oANWCHo/PTuk_TrainDriver/PCB_MotorDriver/3D/5930-0.2mΩ.STEP

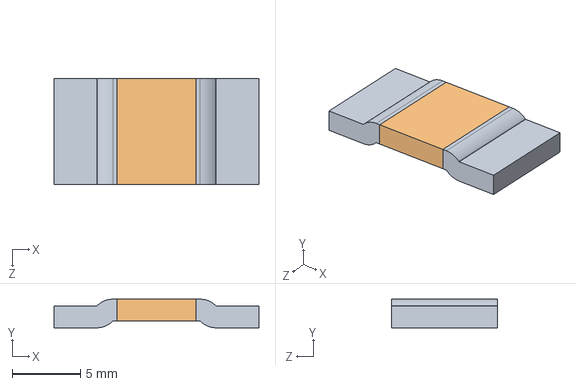
[picture p1: CAD file, 2026-06-28]
PCB_MotorDriver/3D/5930-0.2mΩ.STEP
15.0 x 2.10 x 7.75 mm
