oANWCHo/PTuk_TrainDriver/PCB_TrainController/3D/ESP32-S3-DEVKITC-1-N8R8.step

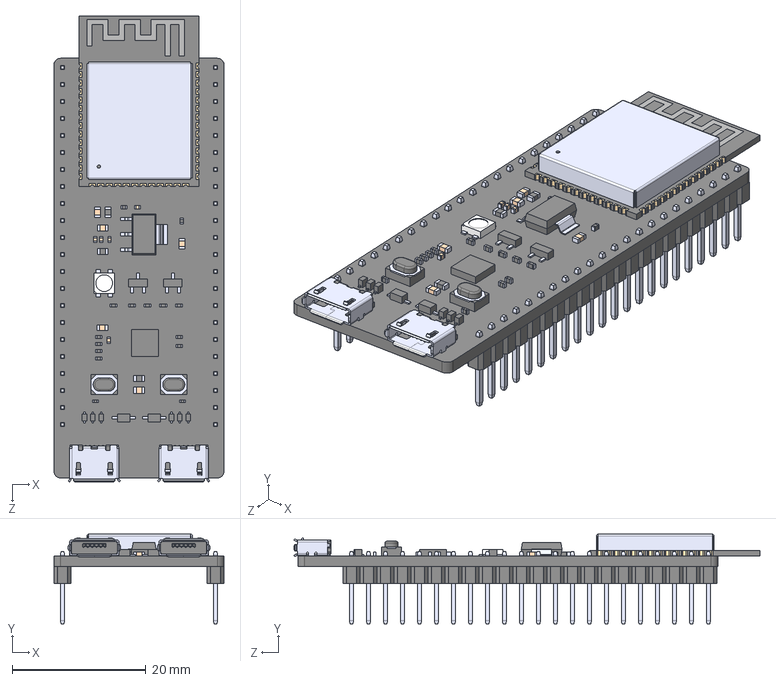
[picture p2: CAD file, 2026-07-12]
PCB_TrainController/3D/ESP32-S3-DEVKITC-1-N8R8.step
25.4 x 13.4 x 69.6 mm
