oANWCHo/PTuk_TrainDriver/PCB_MotorDriver/3D/User Library-TDSON-8-1.STEP

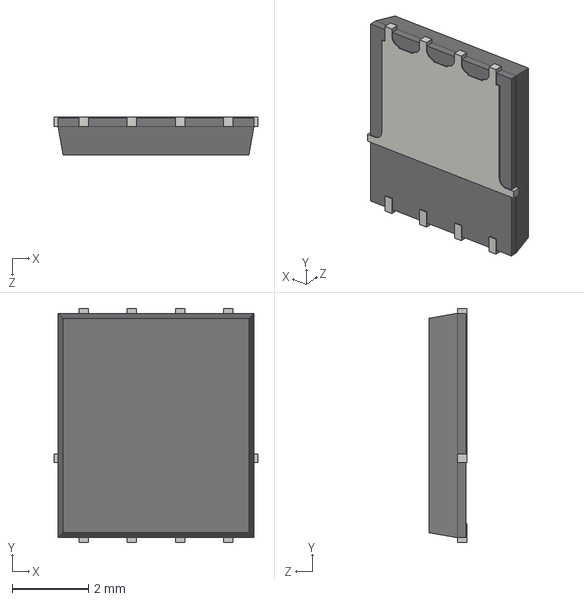
[picture p3: CAD file, 2026-06-28]
PCB_MotorDriver/3D/User Library-TDSON-8-1.STEP
5.35 x 6.15 x 1.00 mm
