oANWCHo/PTuk_TrainDriver/PCB_MotorDriver/3D/XT60PW-M--3DModel-STEP-740395.STEP

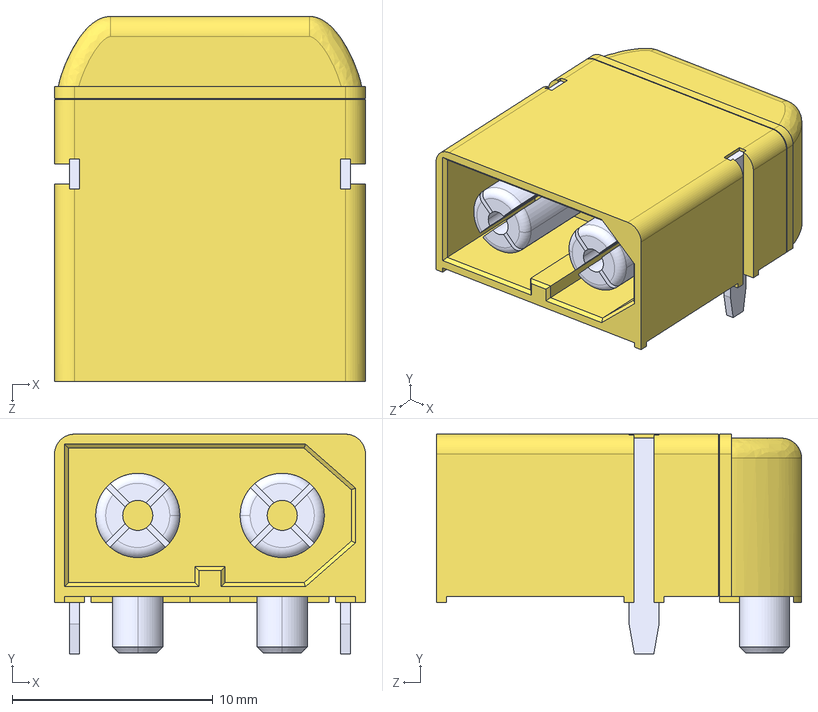
[picture p4: CAD file, 2026-06-28]
PCB_MotorDriver/3D/XT60PW-M--3DModel-STEP-740395.STEP
15.5 x 10.9 x 18.2 mm
