oANWCHo/PTuk_TrainDriver/PCB_MotorDriver/3D/XT90PW-M--3DModel-STEP-56544.STEP

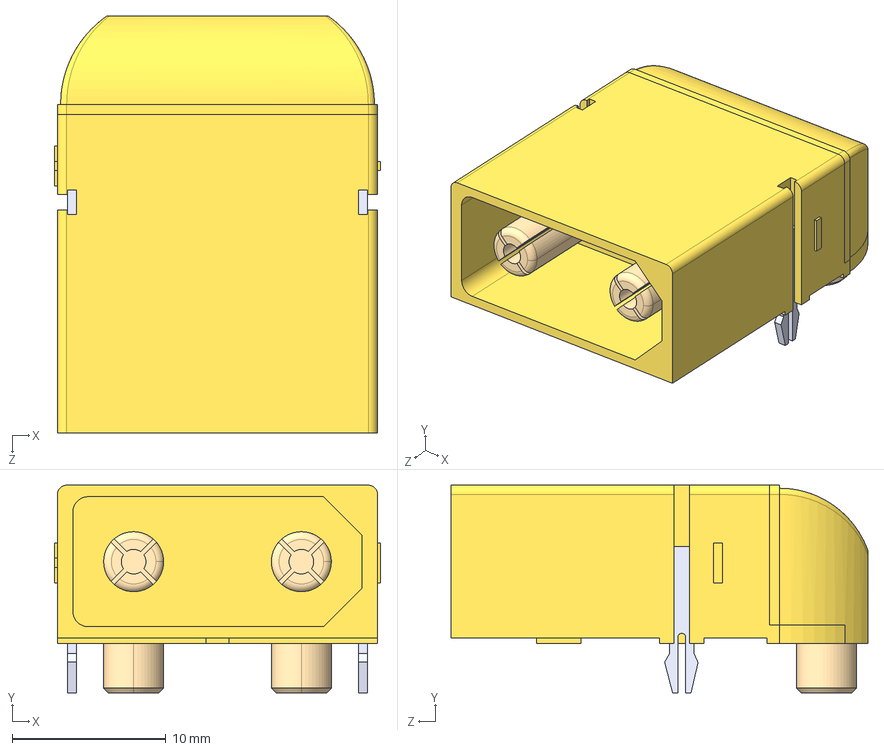
[picture p5: CAD file, 2026-06-28]
PCB_MotorDriver/3D/XT90PW-M--3DModel-STEP-56544.STEP
21.2 x 13.5 x 27.1 mm
