oANWCHo/PTuk_TrainDriver/PCB_MotorDriver/3D/XT30PW-M--3DModel-STEP-269445.STEP

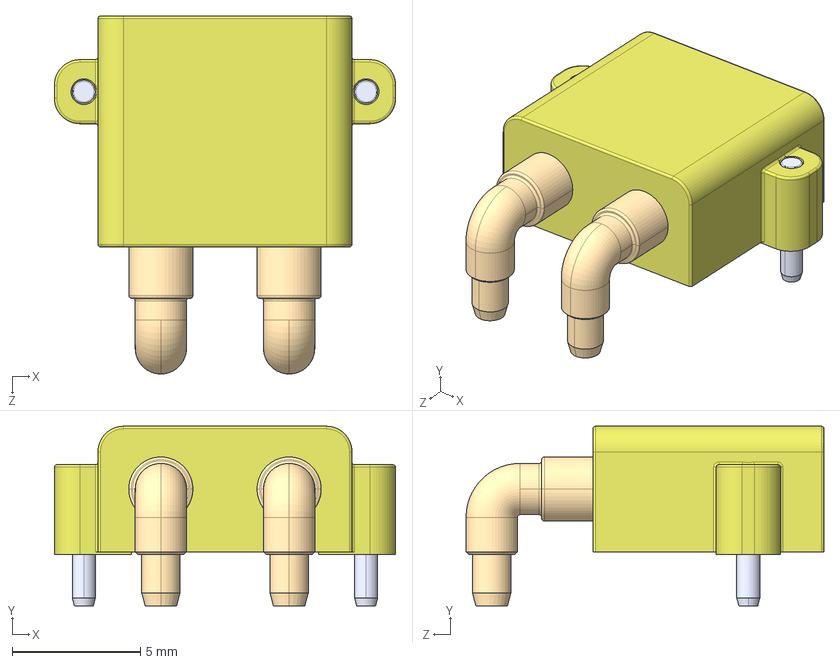
[picture p6: CAD file, 2026-06-28]
PCB_MotorDriver/3D/XT30PW-M--3DModel-STEP-269445.STEP
13.3 x 7.00 x 14.0 mm
