oANWCHo/PTuk_TrainDriver/PCB_TrainDriver/PCB_TrainDriver.kicad_pcb

## KiCad design PCB_TrainDriver/PCB_TrainDriver.kicad_pcb (2026-07-12)

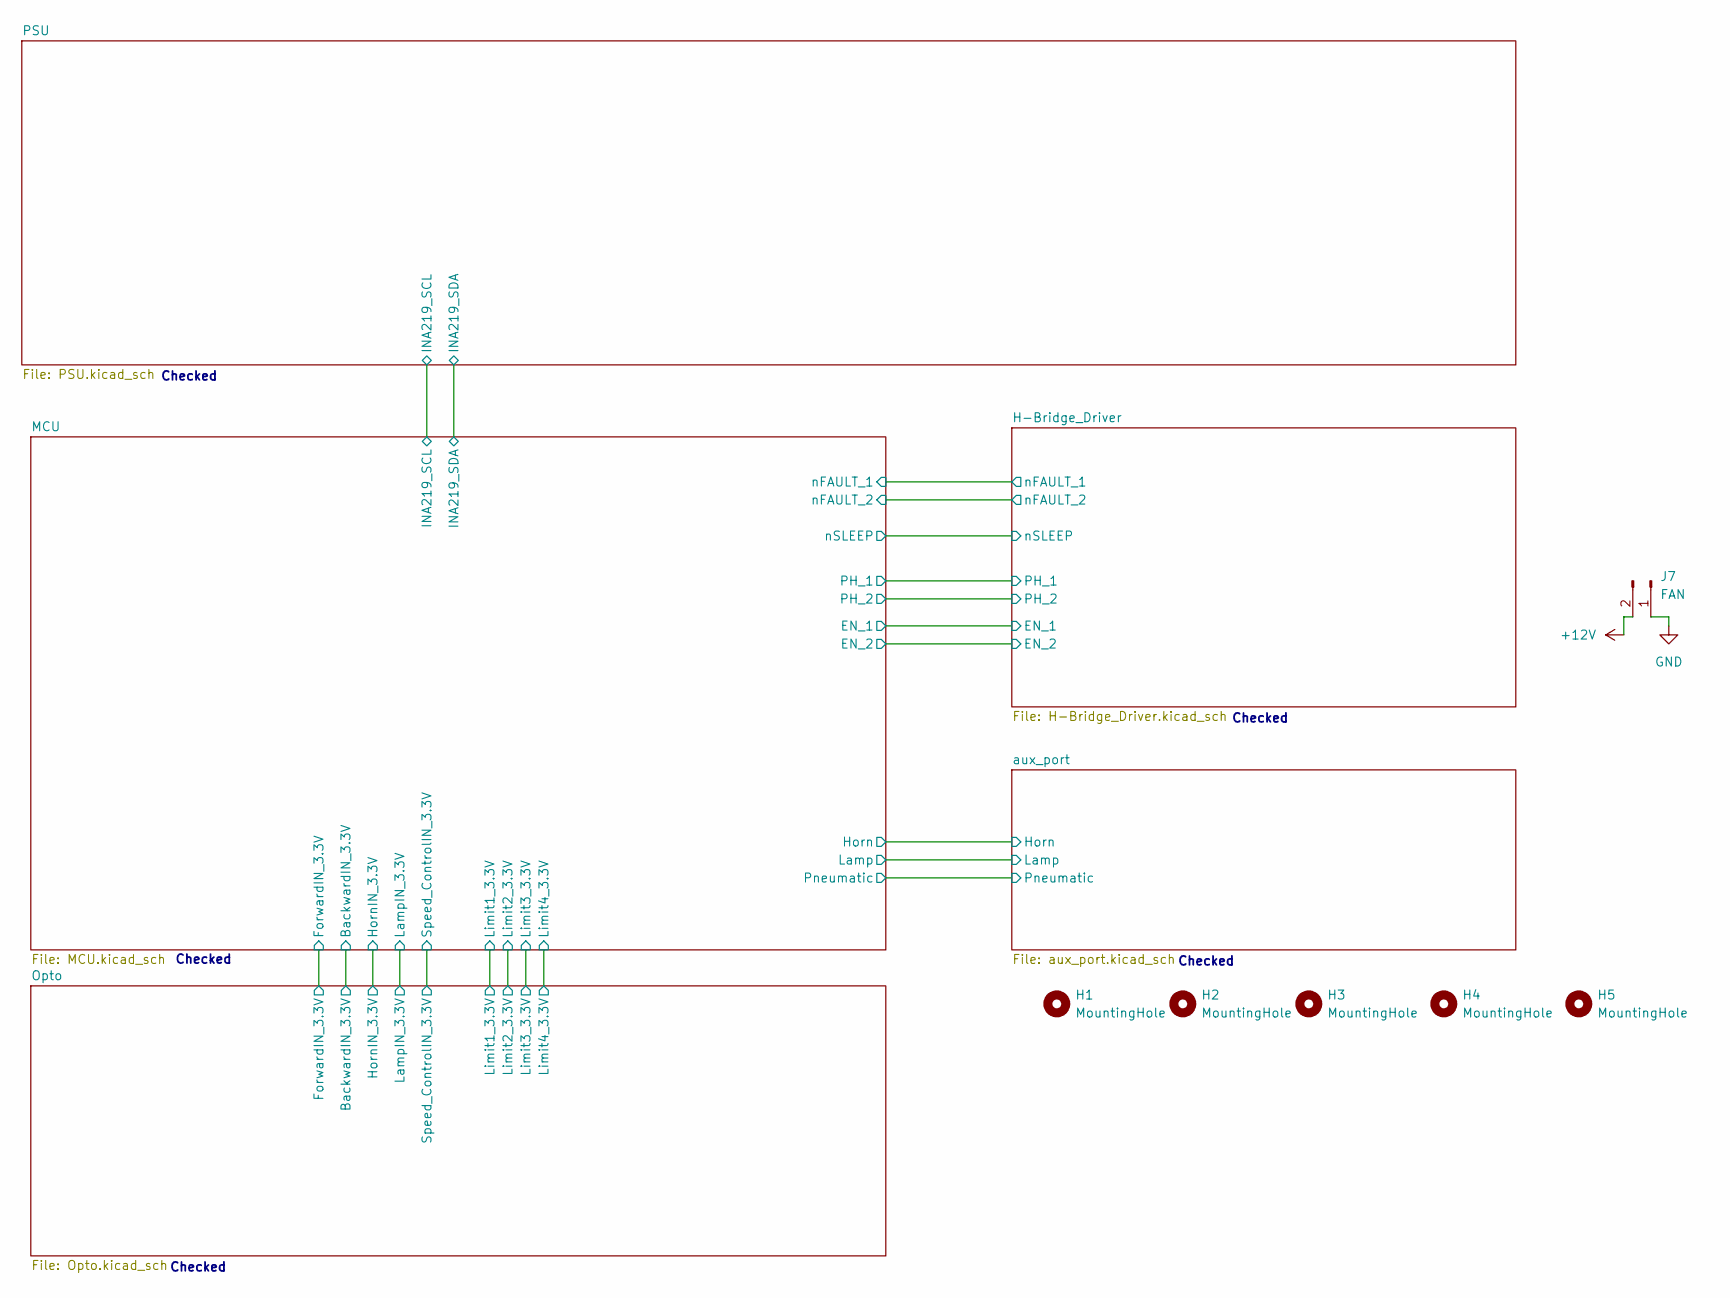
[picture p18: schematic PCB_TrainDriver.kicad_sch]

Parts:
H1, H2, H3, H4, H5: MountingHole; MountingHole_5.3mm_M5_DIN965_Pad
J7: FAN; JST_XA_B02B-XASK-1_1x02_P2.50mm_Vertical; JLCPCB Part # C265283

Connections:
+12V: J7.2; also elsewhere on the board
GND: J7.1; also elsewhere on the board

Notes on the sheet:
Checked

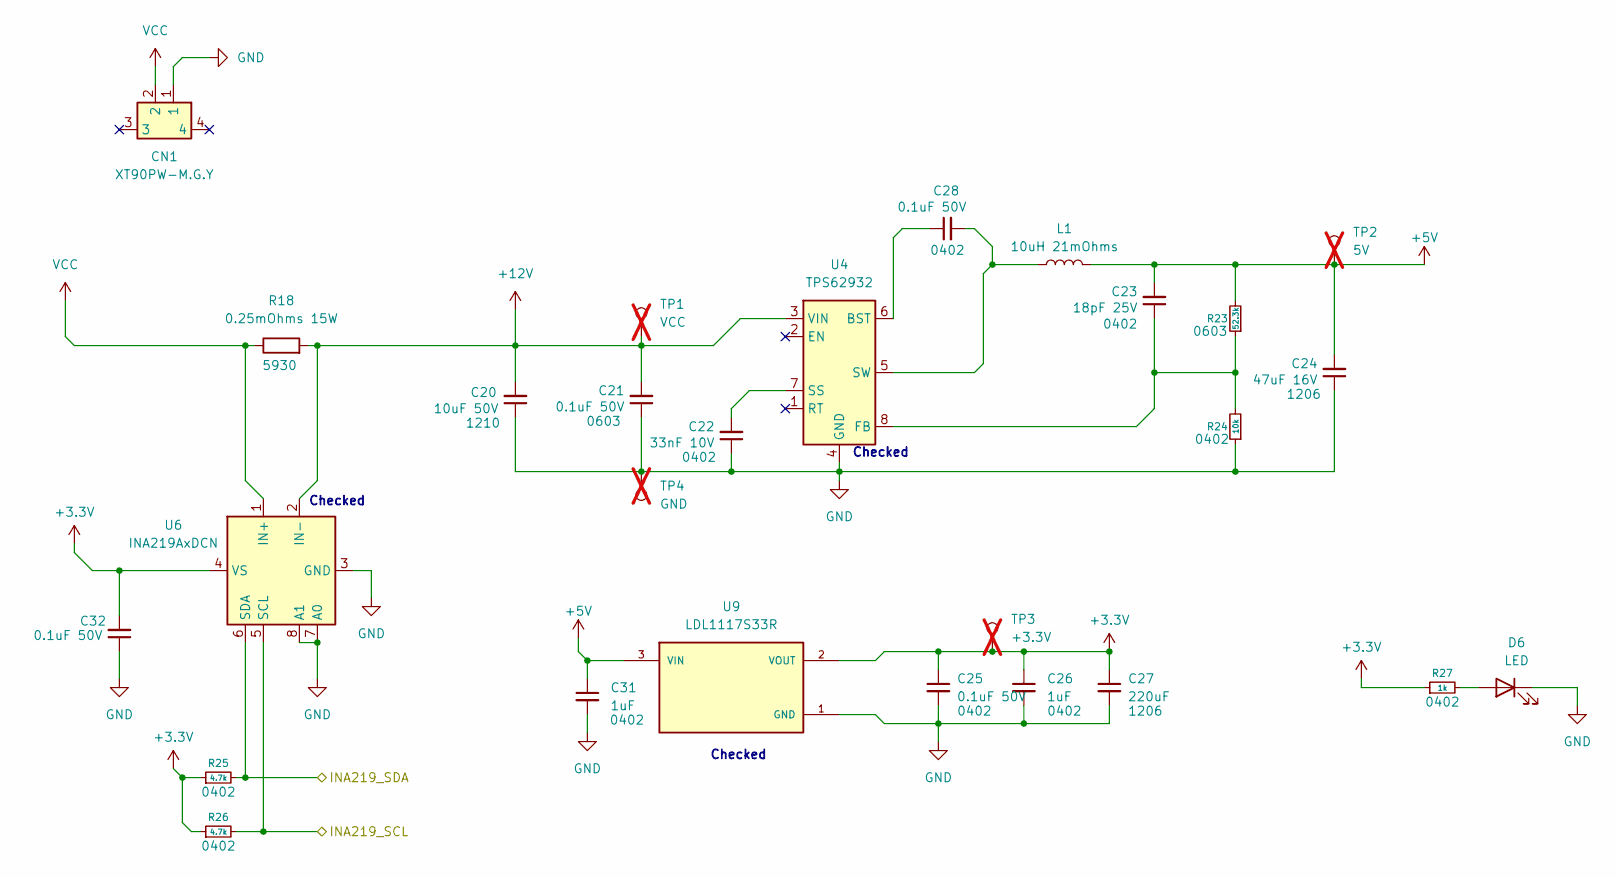
[picture p19: schematic PSU.kicad_sch]

Parts:
C20: 10uF 50V; C_1206_3216Metric; JLCPCB Part # C13585
C21: 0.1uF 50V; C_0603_1608Metric; JLCPCB Part # C14663
C22: 33nF 10V; C_0402_1005Metric; JLCPCB Part # C527022
C23: 18pF 25V; C_0402_1005Metric; JLCPCB Part # C526984
C24: 47uF 16V; C_1206_3216Metric; JLCPCB Part # C7472975
C25, C28, C32: 0.1uF 50V; C_0402_1005Metric; JLCPCB Part # C307331
C26, C31: 1uF; C_0402_1005Metric; JLCPCB Part # C52923
C27: 220uF; C_1206_3216Metric; JLCPCB Part # C412252
CN1: XT90PW-M.G.Y; CONN-TH_XT90PW-M.G.Y; Manufacturer Part XT90PW-M.G.Y; LCSC Part Name AMASS(艾迈斯)PCB焊板式卧式航模连接器 锂电池大电流插头 30A二芯P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
D6: LED; LED_0603_1608Metric; JLCPCB Part # C2286
L1: 10uH 21mOhms; L_12x12mm_H4.5mm; JLCPCB Part # C9904
R18: 0.25mOhms 15W; R5930; JLCPCB Part # C495779
R23: 52.3k; R_0603_1608Metric; JLCPCB Part # C23198
R24: 10k; R_0402_1005Metric; JLCPCB Part # C60490
R25, R26: 4.7k; R_0402_1005Metric; JLCPCB Part # C25900
R27: 1k; R_0402_1005Metric; JLCPCB Part # C11702
TP1: VCC; Pin_D0.7mm_L6.5mm_W1.8mm_FlatFork; not fitted
TP2: 5V; Pin_D0.7mm_L6.5mm_W1.8mm_FlatFork; not fitted
TP3: +3.3V; Pin_D0.7mm_L6.5mm_W1.8mm_FlatFork; not fitted
TP4: GND; Pin_D0.7mm_L6.5mm_W1.8mm_FlatFork; not fitted
U4: TPS62932; SOT-583-8; JLCPCB Part # C3032935
U6: INA219AxDCN; SOT-23-8; JLCPCB Part # C87469
U9: LDL1117S33R; SOT-223-3_TabPin2; PARTREV 7; JLCPCB Part # C18906017

Connections:
+3.3V: C25.1, C26.1, C27.1, C32.2, R25.1, R26.1, R27.1, TP3.1 (1_1), U6.4 (VS), U9.2 (VOUT), U9.4 (VOUT__1); also elsewhere on the board
+5V: C23.2, C24.2, C31.1, L1.2, R23.2, TP2.1 (1_1), U9.3 (VIN)
+12V: C20.2, C21.2, R18.2, TP1.1 (1_1), U4.3 (VIN), U6.2 (IN-); also elsewhere on the board
/MCU/INA219_SCL: R26.2, U6.5 (SCL); also elsewhere on the board
/MCU/INA219_SDA: R25.2, U6.6 (SDA); also elsewhere on the board
GND: C20.1, C21.1, C22.1, C24.1, C25.2, C26.2, C27.2, C31.2, C32.1, CN1.1, D6.1 (K), R24.1, TP4.1 (1_1), U4.4 (GND), U6.3 (GND), U6.7 (A0), U6.8 (A1), U9.1 (GND); also elsewhere on the board
unnamed: D6.2 (A), R27.2
unnamed: C28.1, U4.6 (BST)
unnamed: C23.1, R23.1, R24.2, U4.8 (FB)
unnamed: C22.2, U4.7 (SS)
unnamed: C28.2, L1.1, U4.5 (SW)
VCC: CN1.2, R18.1, U6.1 (IN+)

Notes on the sheet:
Checked

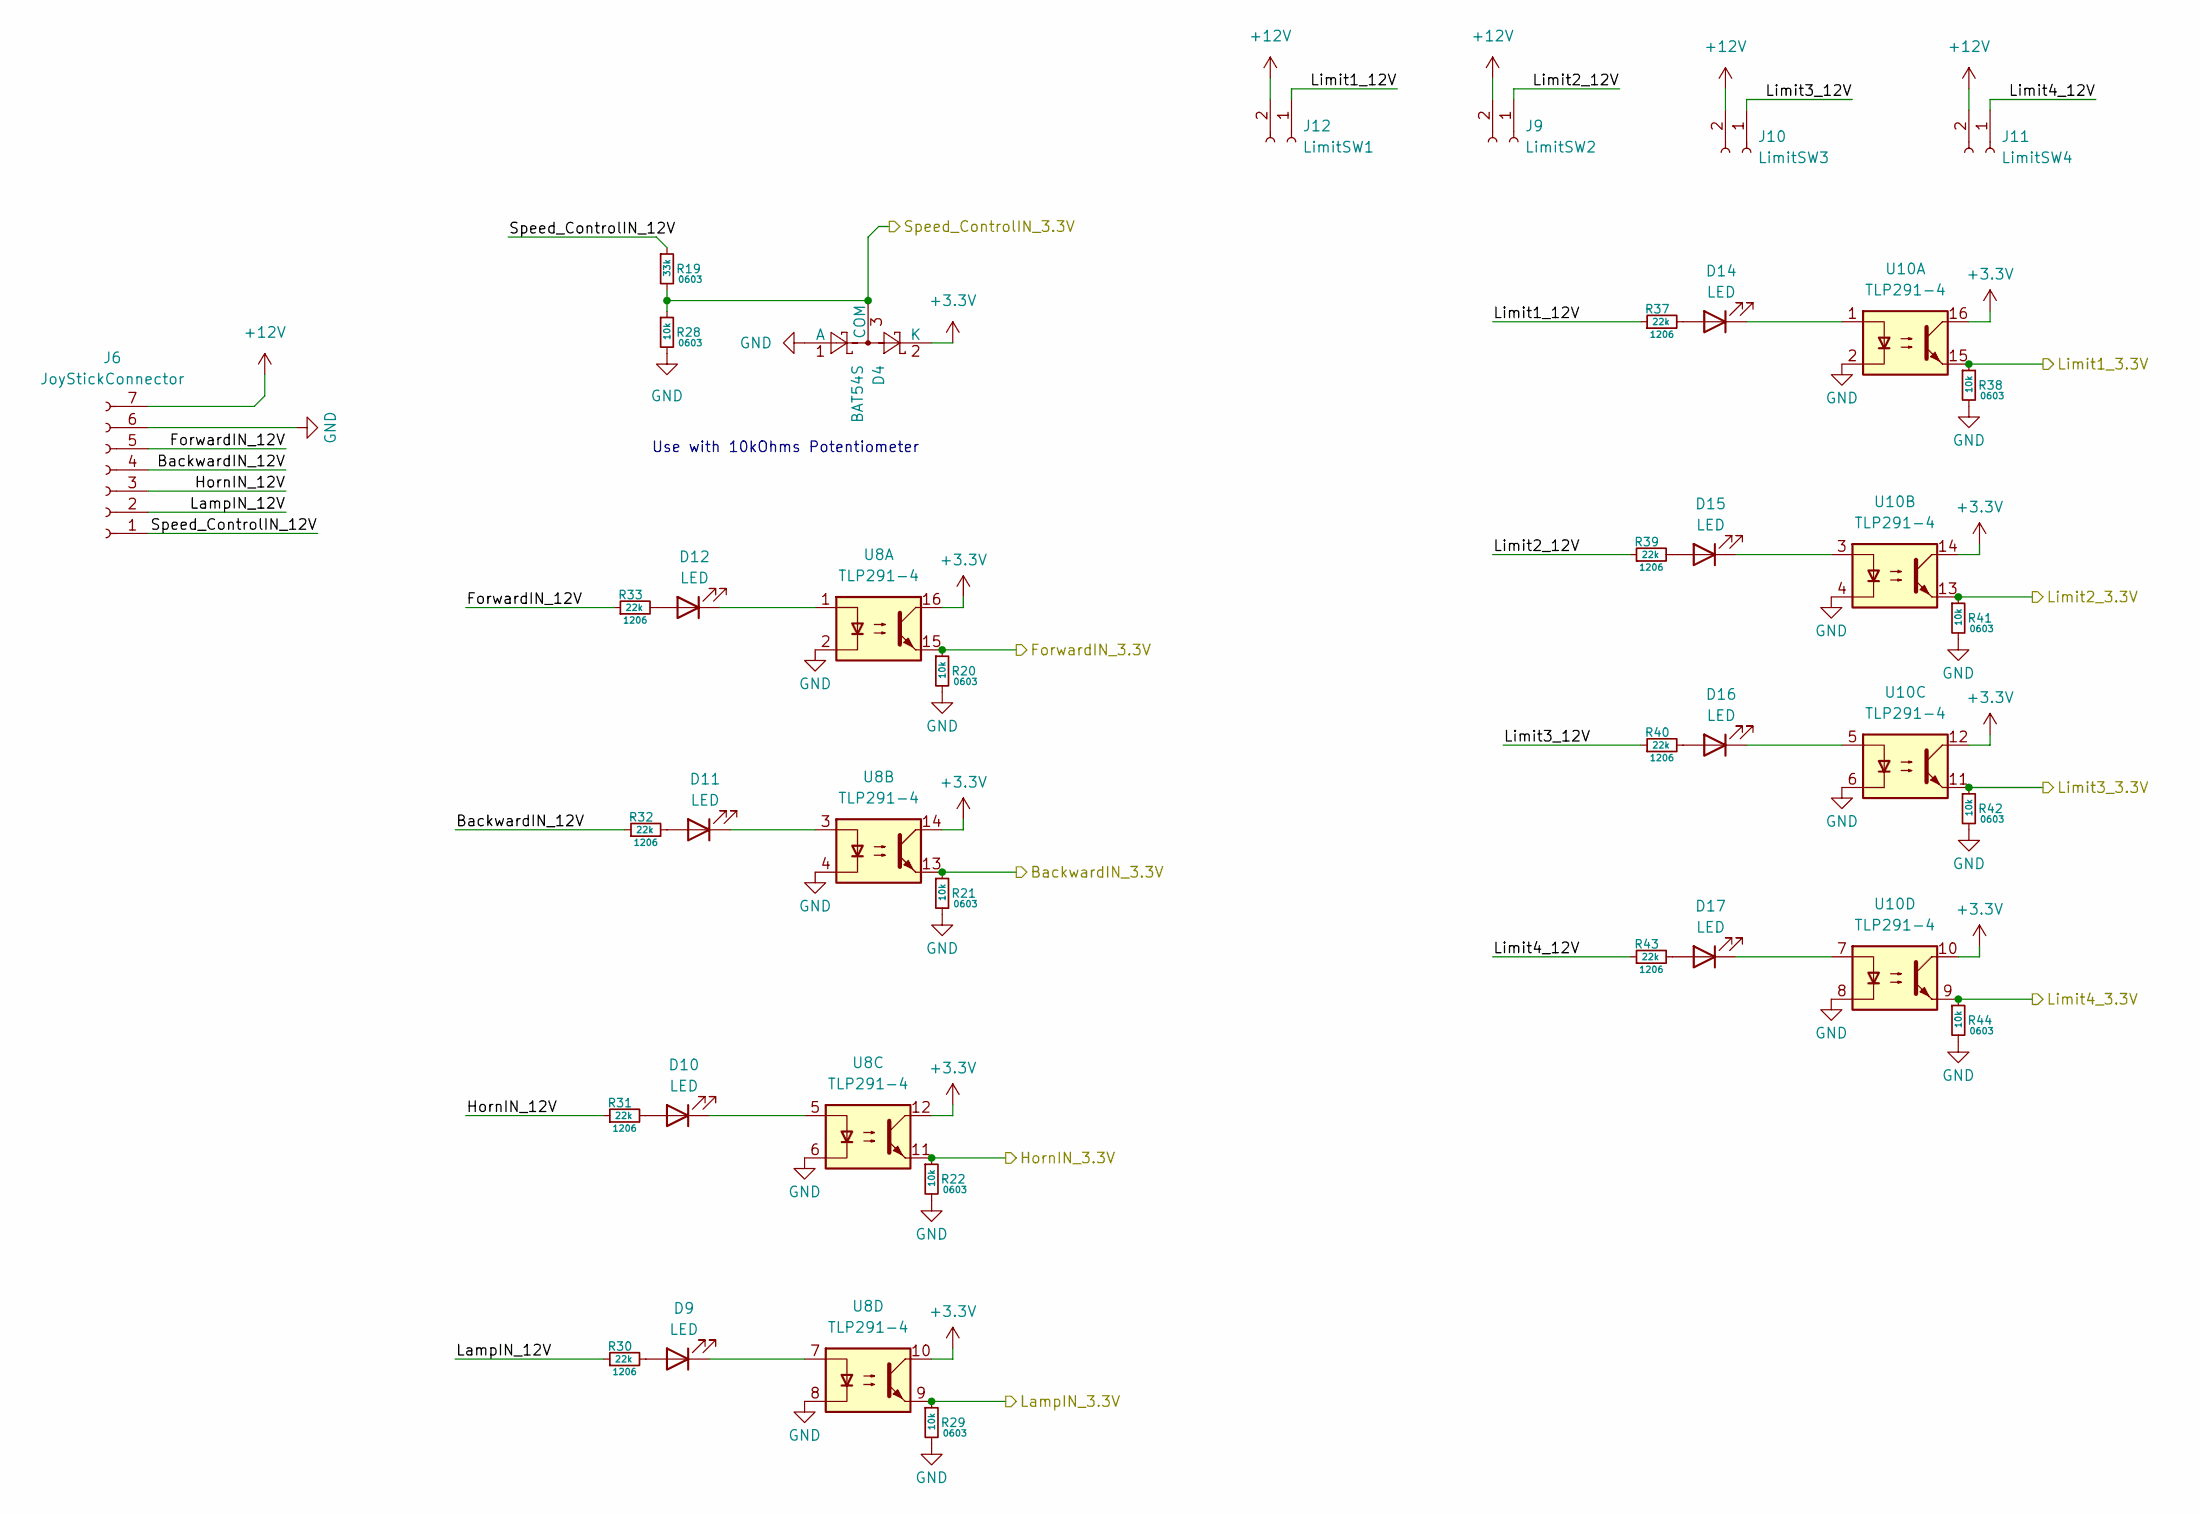
[picture p20: schematic Opto.kicad_sch]

Parts:
D4: BAT54S; SOT-23; JLCPCB Part # C19726
D9, D10, D11, D12, D14, D15, D16, D17: LED; LED_0603_1608Metric; JLCPCB Part # C2287
J6: JoyStickConnector; JST_XH_B7B-XH-A_1x07_P2.50mm_Vertical; JLCPCB Part # C144398
J9: LimitSW2; JST_XH_B2B-XH-A_1x02_P2.50mm_Vertical; JLCPCB Part # C265283
J10: LimitSW3; JST_XH_B2B-XH-A_1x02_P2.50mm_Vertical; JLCPCB Part # C265283
J11: LimitSW4; JST_XH_B2B-XH-A_1x02_P2.50mm_Vertical; JLCPCB Part # C265283
J12: LimitSW1; JST_XH_B2B-XH-A_1x02_P2.50mm_Vertical; JLCPCB Part # C265283
R19: 33k; R_0603_1608Metric; JLCPCB Part # C4216
R20, R21, R22, R28, R29, R38, R41, R42, R44: 10k; R_0603_1608Metric; JLCPCB Part # C25804
R30, R31, R32, R33, R37, R39, R40, R43: 22k; R_1206_3216Metric; JLCPCB Part # C25654
U8, U10: TLP291-4; SOIC-16_4.55x10.3mm_P1.27mm; JLCPCB Part # C60900

Connections:
+3.3V: D4.2 (K), U8.10, U8.12, U8.14, U8.16, U10.10, U10.12, U10.14, U10.16; also elsewhere on the board
+12V: J6.7, J9.2, J10.2, J11.2, J12.2; also elsewhere on the board
/MCU/BackwardIN_3.3V: R21.1, U8.13; also elsewhere on the board
/MCU/ForwardIN_3.3V: R20.1, U8.15; also elsewhere on the board
/MCU/HornIN_3.3V: R22.1, U8.11; also elsewhere on the board
/MCU/LampIN_3.3V: R29.1, U8.9; also elsewhere on the board
/MCU/Limit1_3.3V: R38.1, U10.15; also elsewhere on the board
/MCU/Limit2_3.3V: R41.1, U10.13; also elsewhere on the board
/MCU/Limit3_3.3V: R42.1, U10.11; also elsewhere on the board
/MCU/Limit4_3.3V: R44.1, U10.9; also elsewhere on the board
/MCU/Speed_ControlIN_3.3V: D4.3 (COM), R19.2, R28.1; also elsewhere on the board
/Opto/BackwardIN_12V: J6.4, R32.1
/Opto/ForwardIN_12V: J6.5, R33.1
/Opto/HornIN_12V: J6.3, R31.1
/Opto/LampIN_12V: J6.2, R30.1
/Opto/Limit1_12V: J12.1, R37.1
/Opto/Limit2_12V: J9.1, R39.1
/Opto/Limit3_12V: J10.1, R40.1
/Opto/Limit4_12V: J11.1, R43.1
/Opto/Speed_ControlIN_12V: J6.1, R19.1
GND: D4.1 (A), J6.6, R20.2, R21.2, R22.2, R28.2, R29.2, R38.2, R41.2, R42.2, R44.2, U8.2, U8.4, U8.6, U8.8, U10.2, U10.4, U10.6, U10.8; also elsewhere on the board
unnamed: D9.2 (A), R30.2
unnamed: D9.1 (K), U8.7
unnamed: D10.2 (A), R31.2
unnamed: D10.1 (K), U8.5
unnamed: D11.2 (A), R32.2
unnamed: D11.1 (K), U8.3
unnamed: D12.2 (A), R33.2
unnamed: D12.1 (K), U8.1
unnamed: D14.2 (A), R37.2
unnamed: D14.1 (K), U10.1
unnamed: D15.2 (A), R39.2
unnamed: D15.1 (K), U10.3
unnamed: D16.2 (A), R40.2
unnamed: D16.1 (K), U10.5
unnamed: D17.2 (A), R43.2
unnamed: D17.1 (K), U10.7

Notes on the sheet:
Use with 10kOhms Potentiometer

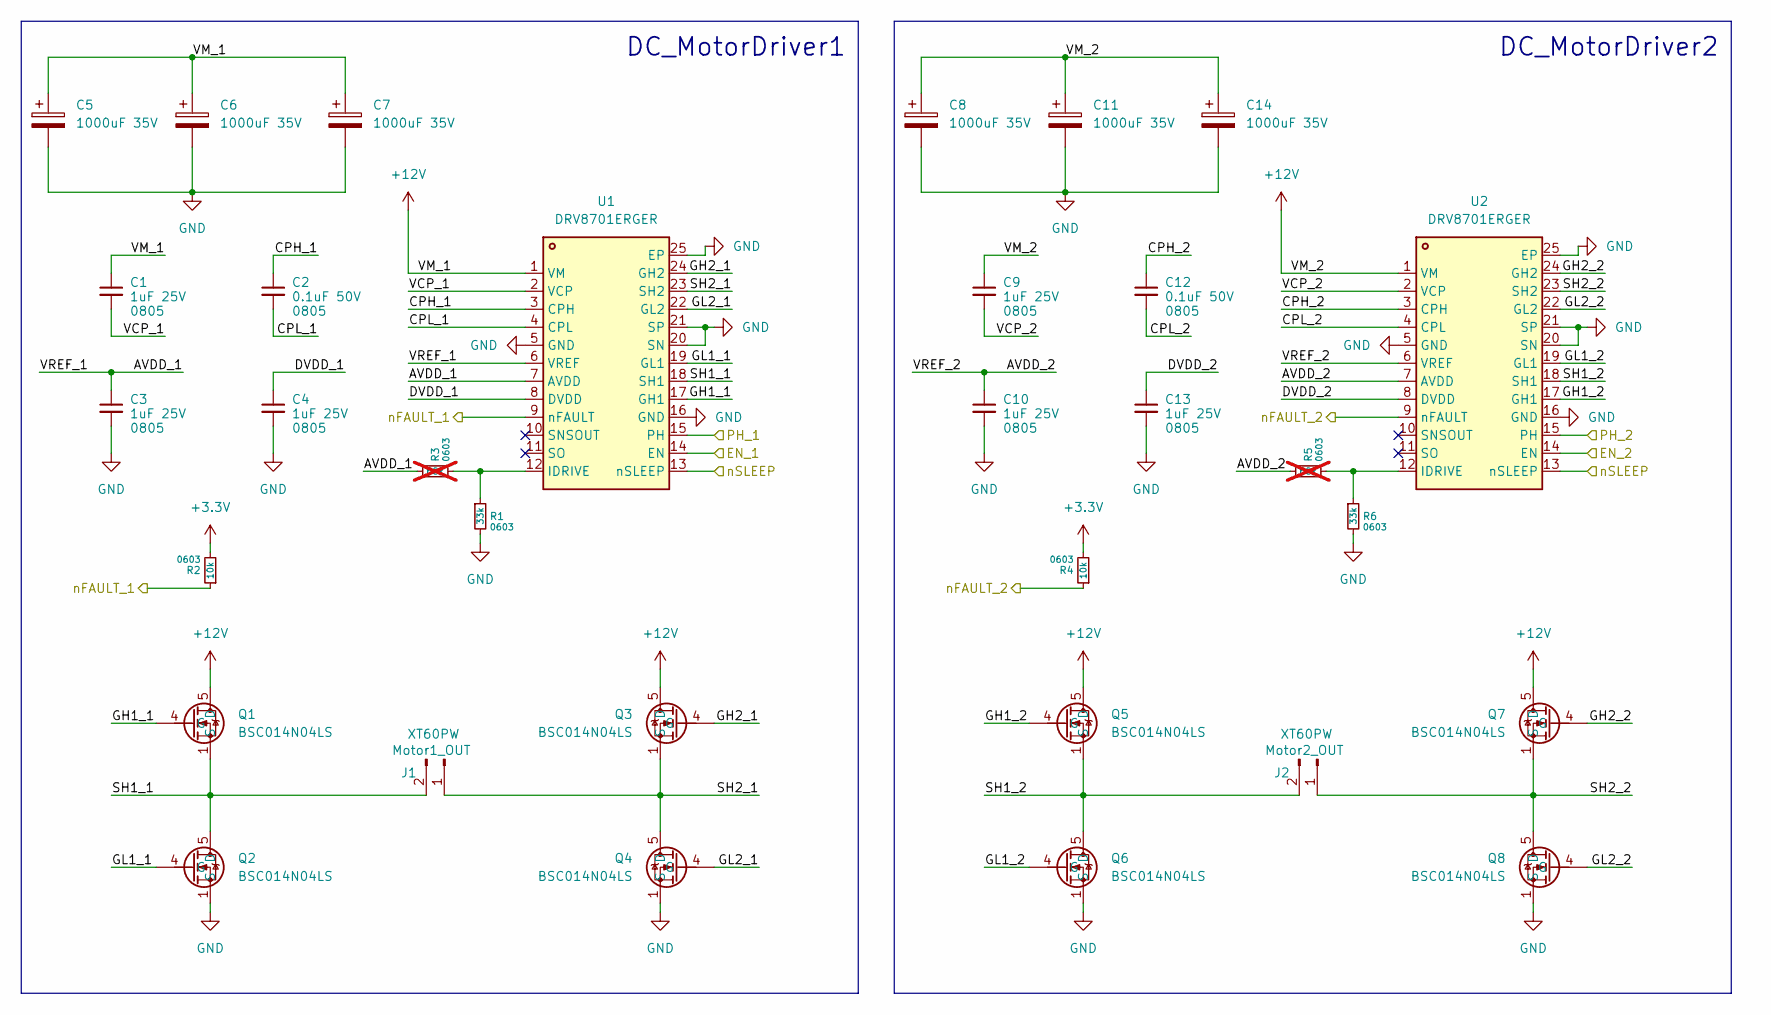
[picture p21: schematic H-Bridge_Driver.kicad_sch]

Parts:
C1, C3, C4, C9, C10, C13: 1uF 25V; C_0805_2012Metric; JLCPCB Part # C5137482
C2, C12: 0.1uF 50V; C_0805_2012Metric; JLCPCB Part # C49678
C5, C6, C7, C8, C11, C14: 1000uF 35V; CP_Elec_10x10; JLCPCB Part # C46550395
J1: Motor1_OUT; AMASS_XT60PW-M_1x02_P7.20mm_Horizontal; JLCPCB Part # C98732
J2: Motor2_OUT; AMASS_XT60PW-M_1x02_P7.20mm_Horizontal; JLCPCB Part # C98732
Q1, Q2, Q3, Q4, Q5, Q6, Q7, Q8: BSC014N04LS; Infineon_PG-TDSON-8_6.15x5.15mm; JLCPCB Part # C2760081
R1, R6: 33k; R_0603_1608Metric; JLCPCB Part # C4216
R2, R4: 10k; R_0603_1608Metric; JLCPCB Part # C25804
R3, R5: 68k; R_0603_1608Metric; JLCPCB Part # C23231; not fitted
U1, U2: DRV8701ERGER; VQFN-24-1EP_4x4mm_P0.5mm_EP2.45x2.45mm; Manufacturer Part DRV8701ERGER; JLCPCB Part # C90964

Connections:
+3.3V: R2.2, R4.2; also elsewhere on the board
+12V: C1.1, C5.1, C6.1, C7.1, C8.1, C9.1, C11.1, C14.1, Q1.5 (D), Q3.5 (D), Q5.5 (D), Q7.5 (D), U1.1 (VM), U2.1 (VM); also elsewhere on the board
/H-Bridge_Driver/AVDD_1: C3.1, R3.1, U1.6 (VREF), U1.7 (AVDD)
/H-Bridge_Driver/AVDD_2: C10.1, R5.1, U2.6 (VREF), U2.7 (AVDD)
/H-Bridge_Driver/CPH_1: C2.1, U1.3 (CPH)
/H-Bridge_Driver/CPH_2: C12.1, U2.3 (CPH)
/H-Bridge_Driver/CPL_1: C2.2, U1.4 (CPL)
/H-Bridge_Driver/CPL_2: C12.2, U2.4 (CPL)
/H-Bridge_Driver/DVDD_1: C4.1, U1.8 (DVDD)
/H-Bridge_Driver/DVDD_2: C13.1, U2.8 (DVDD)
/H-Bridge_Driver/EN_1: U1.14 (EN); also elsewhere on the board
/H-Bridge_Driver/EN_2: U2.14 (EN); also elsewhere on the board
/H-Bridge_Driver/GH1_1: Q1.4 (G), U1.17 (GH1)
/H-Bridge_Driver/GH1_2: Q5.4 (G), U2.17 (GH1)
/H-Bridge_Driver/GH2_1: Q3.4 (G), U1.24 (GH2)
/H-Bridge_Driver/GH2_2: Q7.4 (G), U2.24 (GH2)
/H-Bridge_Driver/GL1_1: Q2.4 (G), U1.19 (GL1)
/H-Bridge_Driver/GL1_2: Q6.4 (G), U2.19 (GL1)
/H-Bridge_Driver/GL2_1: Q4.4 (G), U1.22 (GL2)
/H-Bridge_Driver/GL2_2: Q8.4 (G), U2.22 (GL2)
/H-Bridge_Driver/PH_1: U1.15 (PH); also elsewhere on the board
/H-Bridge_Driver/PH_2: U2.15 (PH); also elsewhere on the board
/H-Bridge_Driver/SH1_1: J1.2, Q1.1 (S), Q1.2 (S), Q1.3 (S), Q2.5 (D), U1.18 (SH1)
/H-Bridge_Driver/SH1_2: J2.2, Q5.1 (S), Q5.2 (S), Q5.3 (S), Q6.5 (D), U2.18 (SH1)
/H-Bridge_Driver/SH2_1: J1.1, Q3.1 (S), Q3.2 (S), Q3.3 (S), Q4.5 (D), U1.23 (SH2)
/H-Bridge_Driver/SH2_2: J2.1, Q7.1 (S), Q7.2 (S), Q7.3 (S), Q8.5 (D), U2.23 (SH2)
/H-Bridge_Driver/VCP_1: C1.2, U1.2 (VCP)
/H-Bridge_Driver/VCP_2: C9.2, U2.2 (VCP)
/H-Bridge_Driver/nFAULT_1: R2.1, U1.9 (nFAULT); also elsewhere on the board
/H-Bridge_Driver/nFAULT_2: R4.1, U2.9 (nFAULT); also elsewhere on the board
/H-Bridge_Driver/nSLEEP: U1.13 (nSLEEP), U2.13 (nSLEEP); also elsewhere on the board
GND: C3.2, C4.2, C5.2, C6.2, C7.2, C8.2, C10.2, C11.2, C13.2, C14.2, Q2.1 (S), Q2.2 (S), Q2.3 (S), Q4.1 (S), Q4.2 (S), Q4.3 (S), Q6.1 (S), Q6.2 (S), Q6.3 (S), Q8.1 (S), Q8.2 (S), Q8.3 (S), R1.2, R6.2, U1.5 (GND), U1.16 (GND), U1.20 (SN), U1.21 (SP), U1.25 (EP), U2.5 (GND), U2.16 (GND), U2.20 (SN), U2.21 (SP), U2.25 (EP); also elsewhere on the board
unnamed: R1.1, R3.2, U1.12 (IDRIVE)
unnamed: R5.2, R6.1, U2.12 (IDRIVE)

Notes on the sheet:
DC_MotorDriver1
DC_MotorDriver2

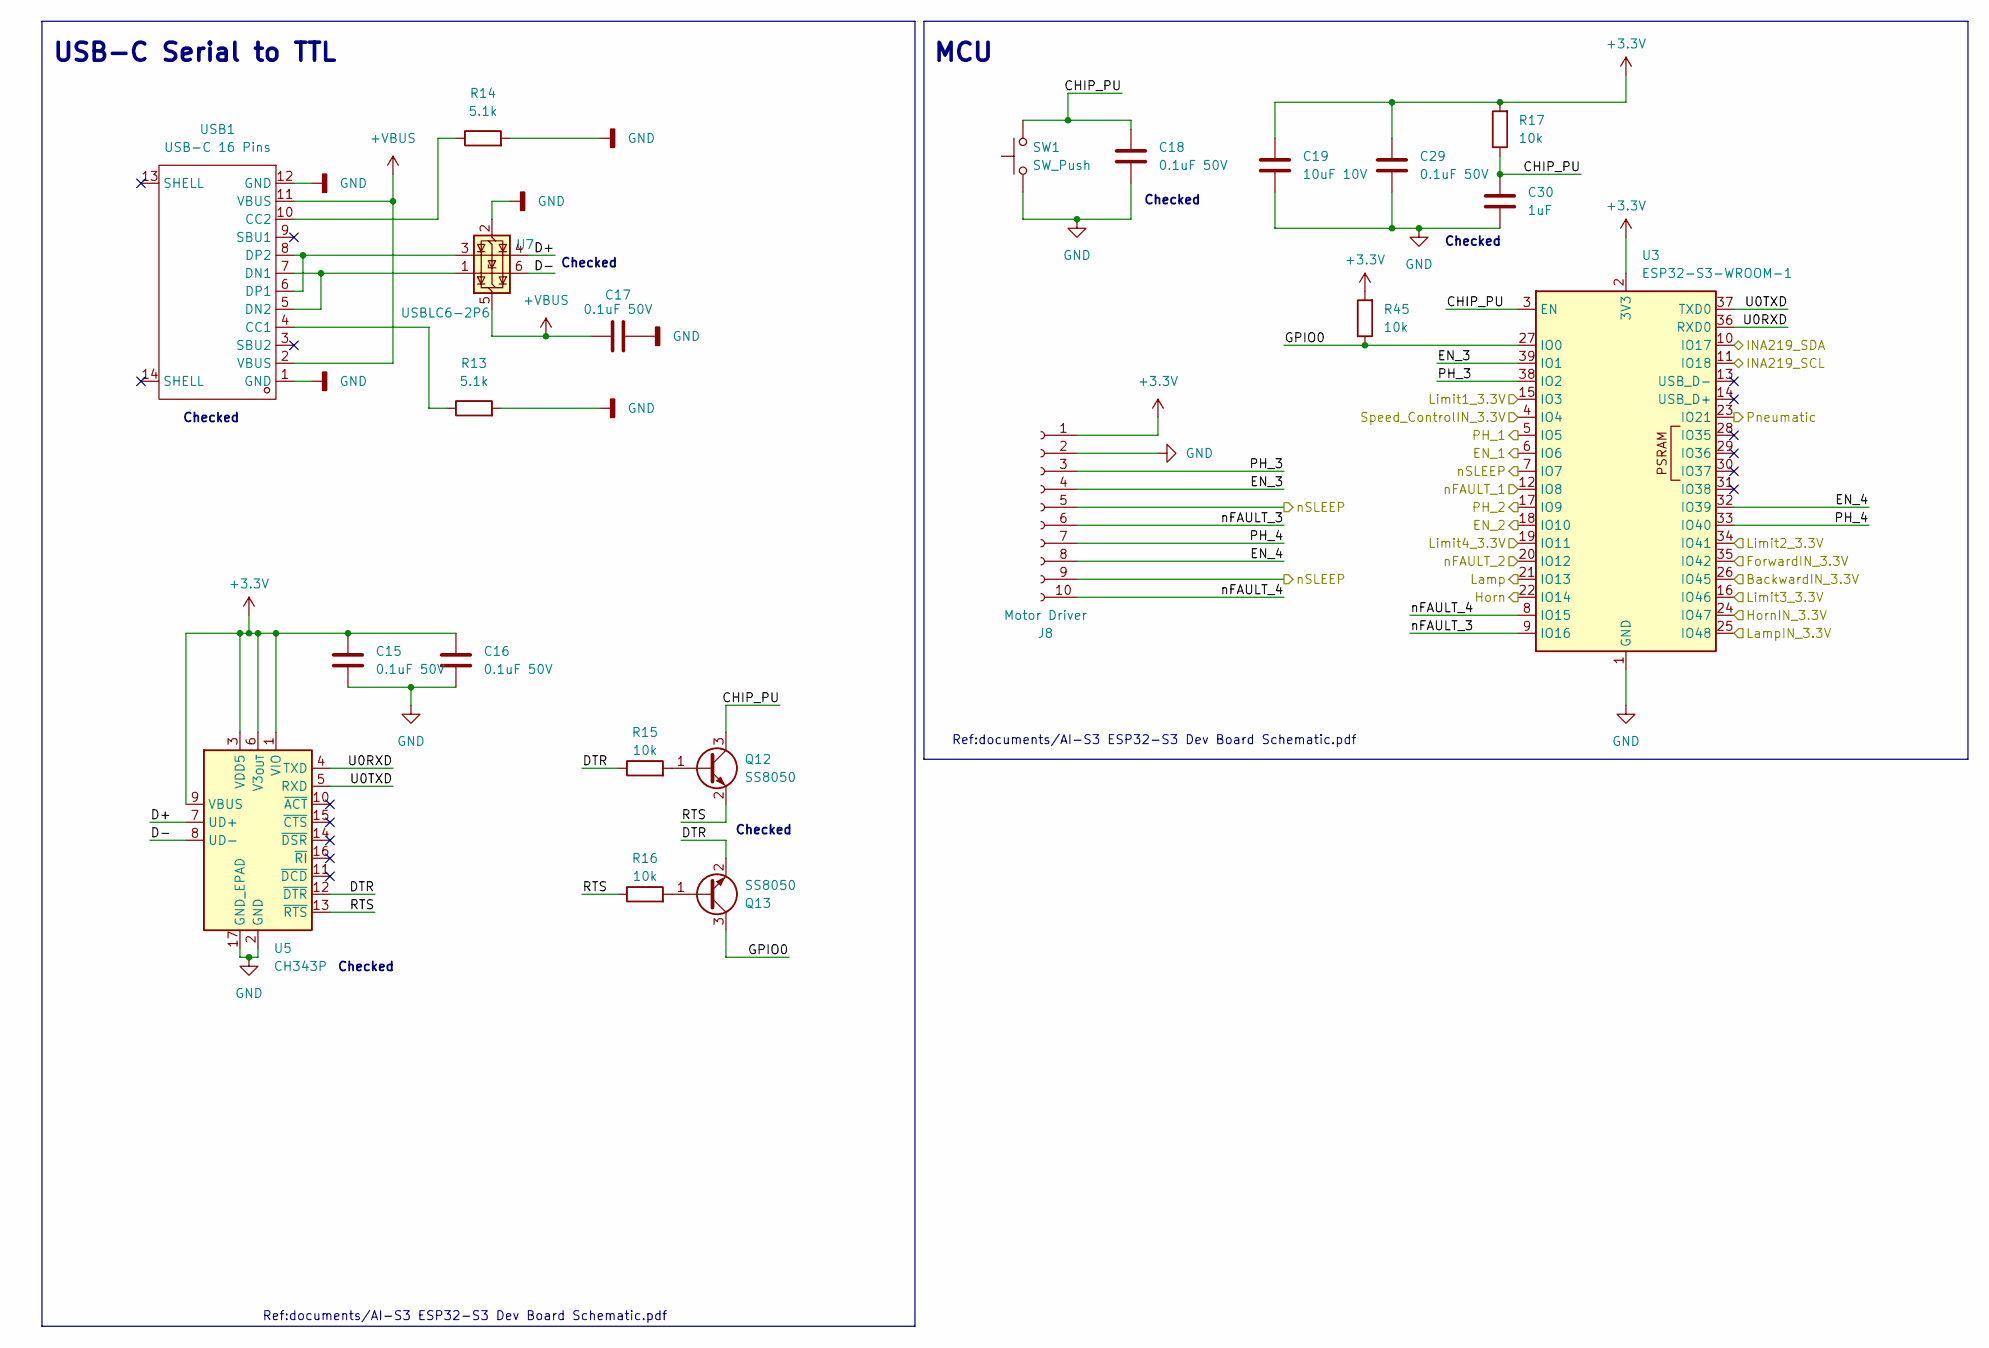
[picture p22: schematic MCU.kicad_sch]

Parts:
C15, C16, C17, C18, C29: 0.1uF 50V; C_0402_1005Metric; JLCPCB Part # C307331
C19: 10uF 10V; C_0402_1005Metric; JLCPCB Part # C2846677
C30: 1uF; C_0402_1005Metric; JLCPCB Part # C52923
J8: Motor Driver; JST_XH_B10B-XH-A_1x10_P2.50mm_Vertical; JLCPCB Part # C144400
Q12, Q13: SS8050; SOT-23; JLCPCB Part # C2150
R13, R14: 5.1k; R_0603_1608Metric; JLCPCB Part # C23186
R15, R16, R17, R45: 10k; R_0402_1005Metric; JLCPCB Part # C60490
SW1: SW_Push; SW_Tactile_SPST_NO_Straight_CK_PTS636Sx25SMTRLFS; JLCPCB Part # C118141
U3: ESP32-S3-WROOM-1; JLCPCB Part # C2913198
U5: CH343P; WCH_QFN-16-1EP_3x3mm_P0.5mm_EP1.8x1.8mm; JLCPCB Part # C2846043
U7: USBLC6-2P6; SOT-666; JLCPCB Part # C15999
USB1: USB-C 16 Pins; USB-C-SMD_TYPE-C-16PIN; Manufacturer Part TYPE-C 16PIN 2MD(073); JLCPCB Part # C393939

Connections:
+3.3V: C15.1, C16.1, C19.1, C29.1, J8.1, R17.2, R45.2, U3.2 (3V3), U5.1 (VIO), U5.3 (VDD5), U5.6 (V3_{OUT}), U5.9 (VBUS); also elsewhere on the board
+VBUS: C17.1, U7.5 (VBUS), USB1.2 (VBUS), USB1.11 (VBUS)
/H-Bridge_Driver/EN_1: U3.6 (IO6); also elsewhere on the board
/H-Bridge_Driver/EN_2: U3.18 (IO10); also elsewhere on the board
/H-Bridge_Driver/PH_1: U3.5 (IO5); also elsewhere on the board
/H-Bridge_Driver/PH_2: U3.17 (IO9); also elsewhere on the board
/H-Bridge_Driver/nFAULT_1: U3.12 (IO8); also elsewhere on the board
/H-Bridge_Driver/nFAULT_2: U3.20 (IO12); also elsewhere on the board
/H-Bridge_Driver/nSLEEP: J8.5, J8.9, U3.7 (IO7); also elsewhere on the board
/MCU/BackwardIN_3.3V: U3.26 (IO45); also elsewhere on the board
/MCU/CHIP_PU: C18.1, C30.1, Q12.3 (C), R17.1, SW1.2, U3.3 (EN)
/MCU/D+: U5.7 (UD+), U7.4 (I/O2)
/MCU/D-: U5.8 (UD-), U7.6 (I/O1)
/MCU/DTR: Q13.2 (E), R15.1, U5.12 (~DTR)
/MCU/EN_3: J8.4, U3.39 (IO1)
/MCU/EN_4: J8.8, U3.32 (IO39)
/MCU/ForwardIN_3.3V: U3.35 (IO42); also elsewhere on the board
/MCU/GPIO0: Q13.3 (C), R45.1, U3.27 (IO0)
/MCU/Horn: U3.22 (IO14); also elsewhere on the board
/MCU/HornIN_3.3V: U3.24 (IO47); also elsewhere on the board
/MCU/INA219_SCL: U3.11 (IO18); also elsewhere on the board
/MCU/INA219_SDA: U3.10 (IO17); also elsewhere on the board
/MCU/Lamp: U3.21 (IO13); also elsewhere on the board
/MCU/LampIN_3.3V: U3.25 (IO48); also elsewhere on the board
/MCU/Limit1_3.3V: U3.15 (IO3); also elsewhere on the board
/MCU/Limit2_3.3V: U3.34 (IO41); also elsewhere on the board
/MCU/Limit3_3.3V: U3.16 (IO46); also elsewhere on the board
/MCU/Limit4_3.3V: U3.19 (IO11); also elsewhere on the board
/MCU/PH_3: J8.3, U3.38 (IO2)
/MCU/PH_4: J8.7, U3.33 (IO40)
/MCU/Pneumatic: U3.23 (IO21); also elsewhere on the board
/MCU/RTS: Q12.2 (E), R16.1, U5.13 (~RTS)
/MCU/Speed_ControlIN_3.3V: U3.4 (IO4); also elsewhere on the board
/MCU/U0RXD: U3.36 (RXD0), U5.4 (TXD)
/MCU/U0TXD: U3.37 (TXD0), U5.5 (RXD)
/MCU/nFAULT_3: J8.6, U3.9 (IO16)
/MCU/nFAULT_4: J8.10, U3.8 (IO15)
GND: C15.2, C16.2, C17.2, C18.2, C19.2, C29.2, C30.2, J8.2, R13.2, R14.2, SW1.1, U3.1 (GND), U3.40 (GND), U3.41 (GND), U5.2 (GND), U5.17 (GND_EPAD), U7.2 (GND), USB1.1 (GND), USB1.12 (GND); also elsewhere on the board
unnamed: Q12.1 (B), R15.2
unnamed: Q13.1 (B), R16.2
unnamed: R13.1, USB1.4 (CC1)
unnamed: R14.1, USB1.10 (CC2)
unnamed: U7.1 (I/O1), USB1.5 (DN2), USB1.7 (DN1)
unnamed: U7.3 (I/O2), USB1.6 (DP1), USB1.8 (DP2)

Notes on the sheet:
Checked
Ref:documents/AI-S3 ESP32-S3 Dev Board Schematic.pdf
MCU
USB-C Serial to TTL

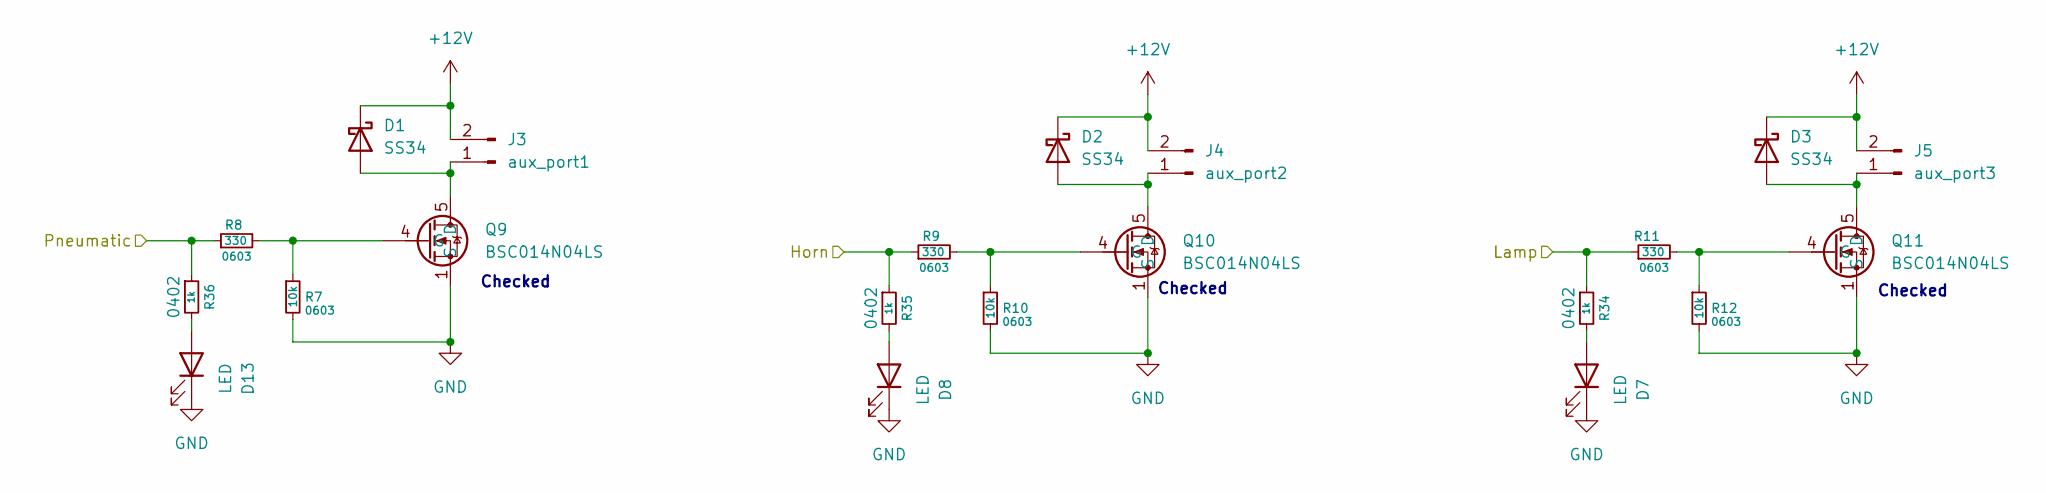
[picture p23: schematic aux_port.kicad_sch]

Parts:
D1, D2, D3: SS34; D_SMA; JLCPCB Part # C8678
D7, D8, D13: LED; LED_0603_1608Metric; JLCPCB Part # C2286
J3: aux_port1; AMASS_XT30PW-M_1x02_P2.50mm_Horizontal; JLCPCB Part # C431092
J4: aux_port2; AMASS_XT30PW-M_1x02_P2.50mm_Horizontal; JLCPCB Part # C431092
J5: aux_port3; AMASS_XT30PW-M_1x02_P2.50mm_Horizontal; JLCPCB Part # C431092
Q9, Q10, Q11: BSC014N04LS; Infineon_PG-TDSON-8_6.15x5.15mm; JLCPCB Part # C2760081
R7, R10, R12: 10k; R_0603_1608Metric; JLCPCB Part # C25804
R8, R9, R11: 330; R_0603_1608Metric; JLCPCB Part # C23138
R34, R35, R36: 1k; R_0402_1005Metric; JLCPCB Part # C11702

Connections:
+12V: D1.1 (K), D2.1 (K), D3.1 (K), J3.2, J4.2, J5.2; also elsewhere on the board
/MCU/Horn: R9.1, R35.1; also elsewhere on the board
/MCU/Lamp: R11.1, R34.1; also elsewhere on the board
/MCU/Pneumatic: R8.1, R36.1; also elsewhere on the board
GND: D7.1 (K), D8.1 (K), D13.1 (K), Q9.1 (S), Q9.2 (S), Q9.3 (S), Q10.1 (S), Q10.2 (S), Q10.3 (S), Q11.1 (S), Q11.2 (S), Q11.3 (S), R7.2, R10.2, R12.2; also elsewhere on the board
unnamed: D1.2 (A), J3.1, Q9.5 (D)
unnamed: D2.2 (A), J4.1, Q10.5 (D)
unnamed: D3.2 (A), J5.1, Q11.5 (D)
unnamed: D7.2 (A), R34.2
unnamed: D8.2 (A), R35.2
unnamed: D13.2 (A), R36.2
unnamed: Q9.4 (G), R7.1, R8.2
unnamed: Q10.4 (G), R9.2, R10.1
unnamed: Q11.4 (G), R11.2, R12.1

Notes on the sheet:
Checked

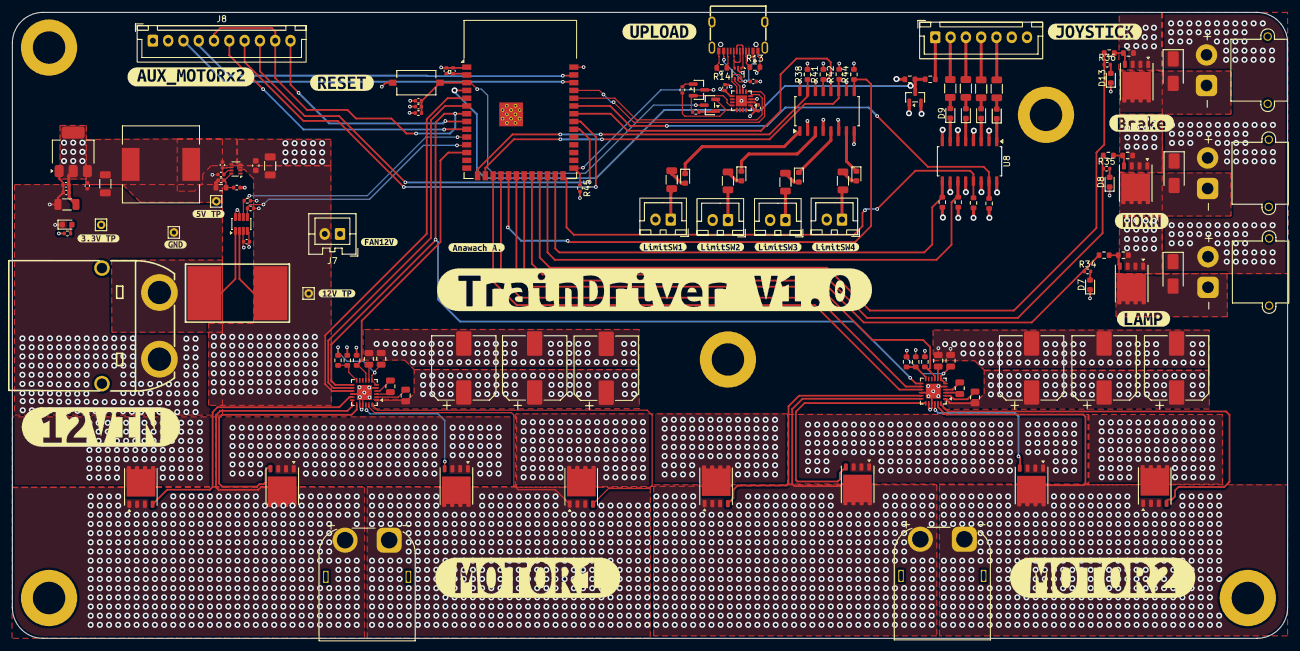
[picture p24: board PCB_TrainDriver.kicad_pcb from above]

Board: 4 copper layers, 208.5 x 102.3 mm, 162 parts (0 on the bottom side), 110 nets.

Other parts of the board:
kibuzzard-6A50A23A: G***; kibuzzard-6A50A23A
kibuzzard-6A412E6E: G***; kibuzzard-6A412E6E
kibuzzard-6A412E9B: G***; kibuzzard-6A412E9B
kibuzzard-6A412E14: G***; kibuzzard-6A412E14
kibuzzard-6A412E20: G***; kibuzzard-6A412E20
kibuzzard-6A412E33: G***; kibuzzard-6A412E33
kibuzzard-6A412E56: G***; kibuzzard-6A412E56
kibuzzard-6A412EAB: G***; kibuzzard-6A412EAB
kibuzzard-6A412ECC: G***; kibuzzard-6A412ECC
kibuzzard-6A412EE2: G***; kibuzzard-6A412EE2
kibuzzard-6A412F0B: G***; kibuzzard-6A412F0B
kibuzzard-6A412F26: G***; kibuzzard-6A412F26
kibuzzard-6A412FC6: G***; kibuzzard-6A412FC6
kibuzzard-6A412FD5: G***; kibuzzard-6A412FD5
kibuzzard-6A412FE5: G***; kibuzzard-6A412FE5
kibuzzard-6A412FEF: G***; kibuzzard-6A412FEF
kibuzzard-6A536EEE: G***; kibuzzard-6A536EEE
kibuzzard-6A538FDD: G***; kibuzzard-6A538FDD
kibuzzard-6A538FF4: G***; kibuzzard-6A538FF4
kibuzzard-6A538FFC: G***; kibuzzard-6A538FFC
kibuzzard-6A539003: G***; kibuzzard-6A539003
