oANWCHo/PTuk_TrainDriver/PCB_TrainController/PCB_TrainController.kicad_pcb

## KiCad design PCB_TrainController/PCB_TrainController.kicad_pcb (2026-07-12)

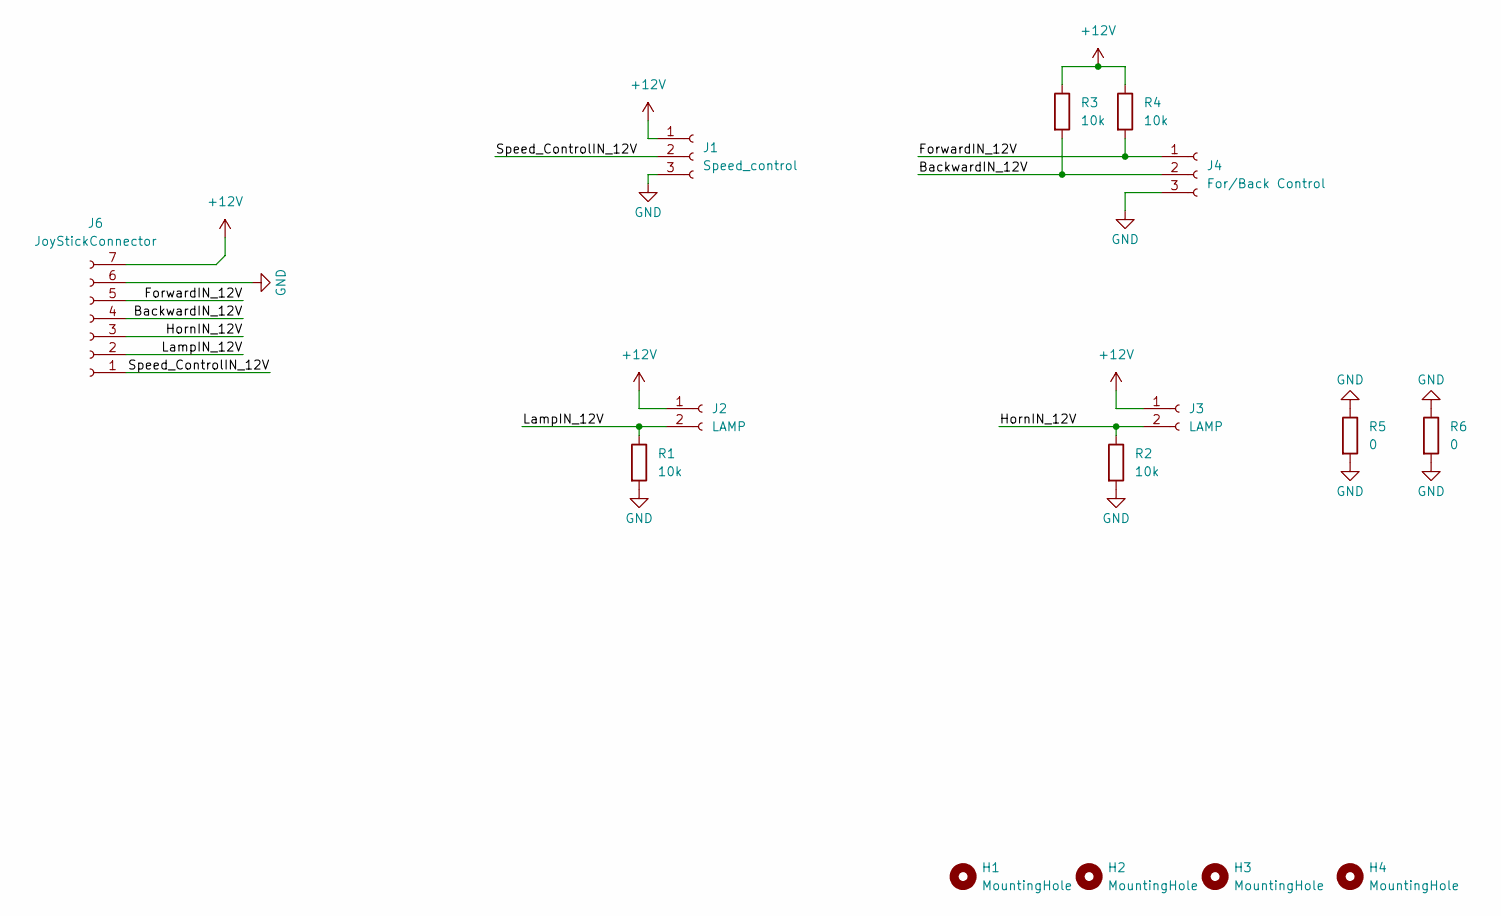
[picture p25: schematic PCB_TrainController.kicad_sch]

Parts:
H1, H2, H3, H4: MountingHole; MountingHole_3.2mm_M3_DIN965_Pad_TopBottom
J1: Speed_control; JST_XH_B3B-XH-A_1x03_P2.50mm_Vertical
J2, J3: LAMP; JST_XH_B2B-XH-A_1x02_P2.50mm_Vertical
J4: For/Back Control; JST_XH_B3B-XH-A_1x03_P2.50mm_Vertical
J6: JoyStickConnector; JST_XH_S7B-XH-A_1x07_P2.50mm_Horizontal
R1, R2, R3, R4: 10k; R_0805_2012Metric
R5, R6: 0; R_Axial_DIN0204_L3.6mm_D1.6mm_P5.08mm_Horizontal

Connections:
+12V: J1.1, J2.1, J3.1, J6.7, R3.1, R4.1
/BackwardIN_12V: J4.2, J6.4, R3.2
/ForwardIN_12V: J4.1, J6.5, R4.2
/HornIN_12V: J3.2, J6.3, R2.1
/LampIN_12V: J2.2, J6.2, R1.1
/Speed_ControlIN_12V: J1.2, J6.1
GND: J1.3, J4.3, J6.6, R1.2, R2.2, R5.1, R5.2, R6.1, R6.2

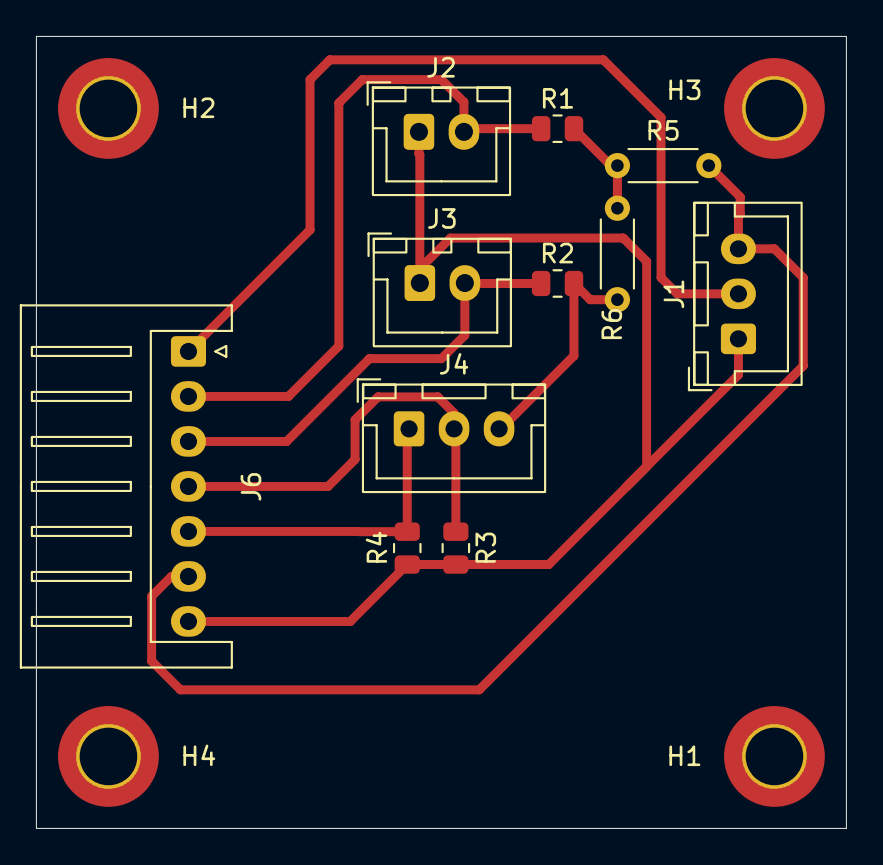
[picture p26: board PCB_TrainController.kicad_pcb from above]

Board: 2 copper layers, 45.0 x 44.0 mm, 15 parts (0 on the bottom side), 7 nets.
