oANWCHo/PTuk_TrainDriver/(commit log)

2026-06-21 Finished MotorDriver and Aux pins
    [H-Bridge_Driver.kicad_sch, PCB_TrainDriver.kicad_pcb, PCB_TrainDriver.kicad_sch, aux_port.kicad_sch]
2026-06-27 Finished sch
    [H-Bridge_Driver.kicad_sch, MCU.kicad_sch, PCB_TrainDriver.kicad_pcb, PCB_TrainDriver.kicad_sch, PSU.kicad_sch, VandISense.kicad_sch, aux_port.kicad_sch, untitled.kicad_sch]
2026-06-28 PCB Almost Finished
    [H-Bridge_Driver.kicad_sch, MCU.kicad_sch, Opto.kicad_sch, PCB_TrainDriver.kicad_pcb, PCB_TrainDriver.kicad_sch, PSU.kicad_sch, User Library-TDSON-8-1.STEP, XT30PW-M--3DModel-STEP-269445.STEP]
2026-06-28 Add aux led indicator
    [5930-0.2mΩ.STEP, Opto.kicad_sch, PCB_TrainDriver.kicad_pcb, PSU.kicad_sch, aux_port.kicad_sch]
2026-07-08 Separate out motor driver
    [5930-0.2mΩ.STEP, H-Bridge_Driver.kicad_sch, MCU.kicad_sch, Opto.kicad_sch, PCB_MotorDriver.kicad_pcb, PCB_MotorDriver.kicad_sch, PCB_TrainController.kicad_pcb, PCB_TrainController.kicad_sch]
